doka312/SmartDesktopLamp/docs/img/build/IMG_5998-sm.jpg

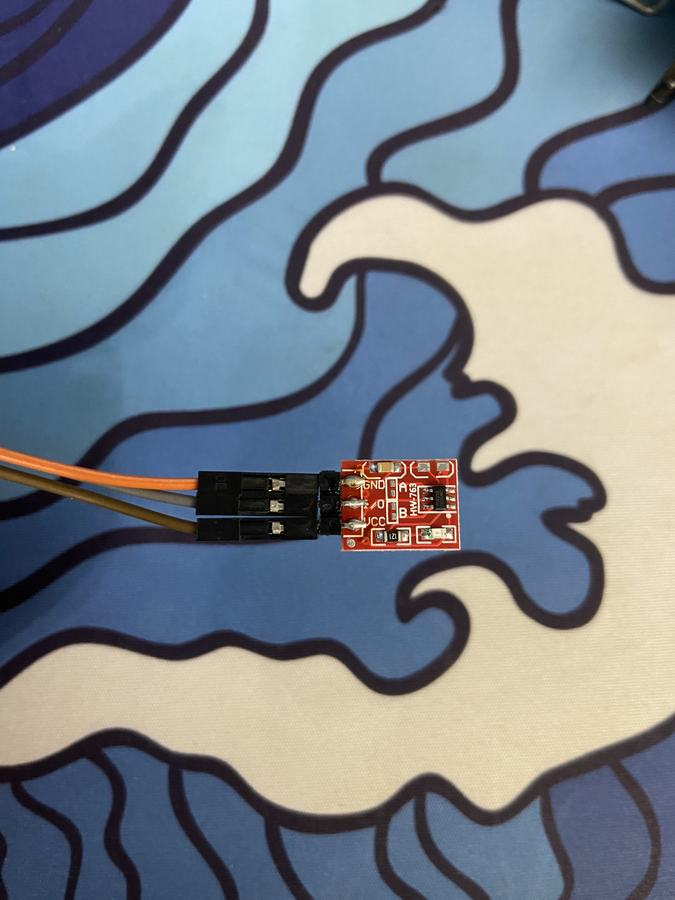
docs/img/build/IMG_5998-sm.jpg
