doka312/SmartDesktopLamp/docs/img/build/IMG_6002.jpg

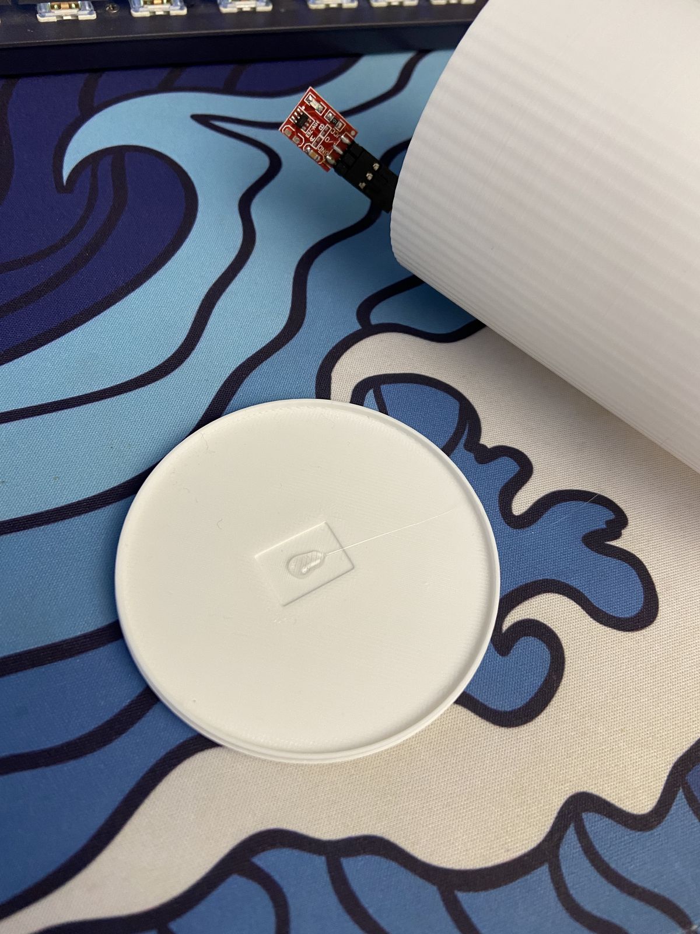
docs/img/build/IMG_6002.jpg
