doka312/SmartDesktopLamp/docs/img/chrome-port.png

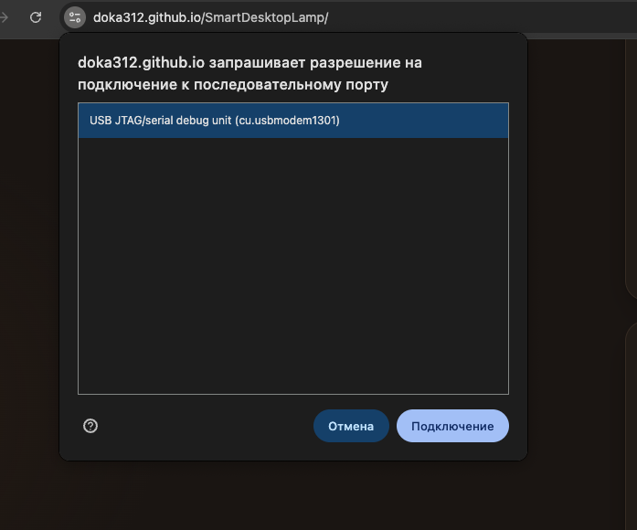
docs/img/chrome-port.png
