doka312/SmartDesktopLamp/docs/img/hero.jpg

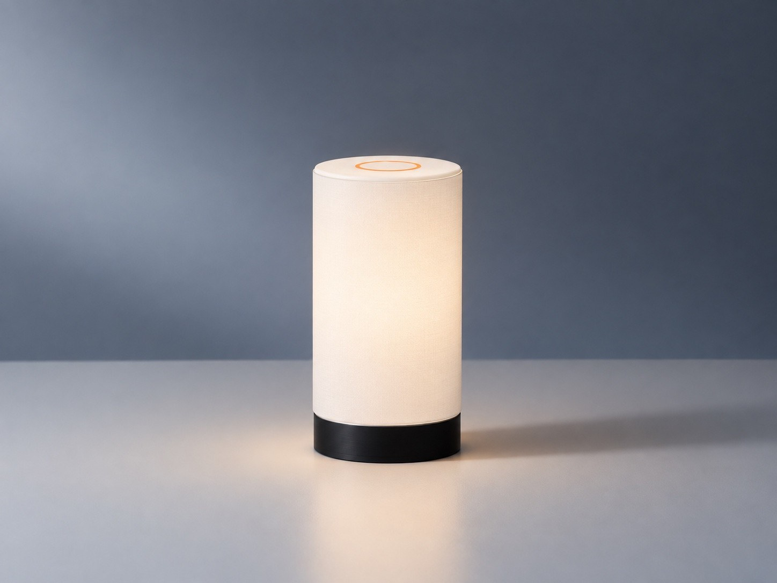
docs/img/hero.jpg
