doka312/SmartDesktopLamp/docs/img/palette.png

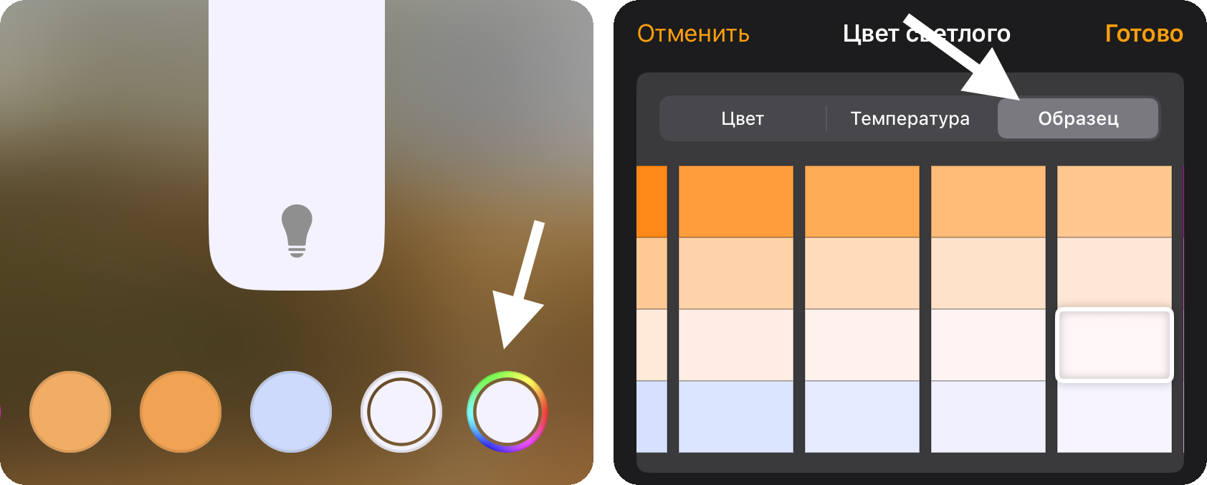
docs/img/palette.png
