doka312/SmartDesktopLamp/docs/img/tile-1.png

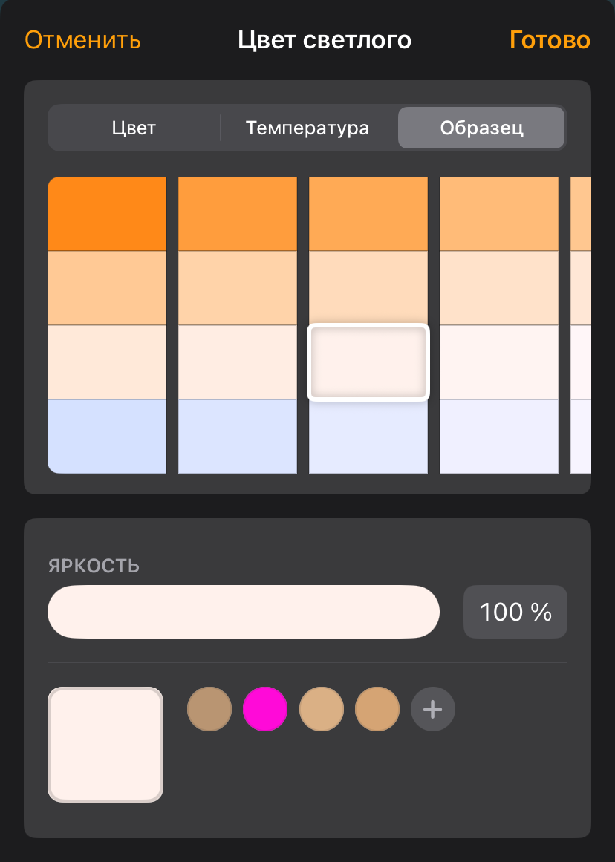
docs/img/tile-1.png
