doka312/SmartDesktopLamp/img/IMG_5999.JPG

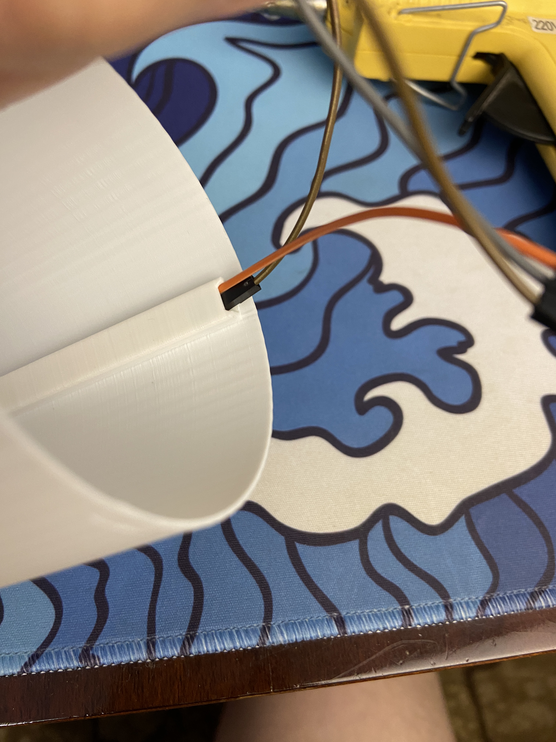
img/IMG_5999.JPG
