doka312/SmartDesktopLamp/img/IMG_6001.JPG

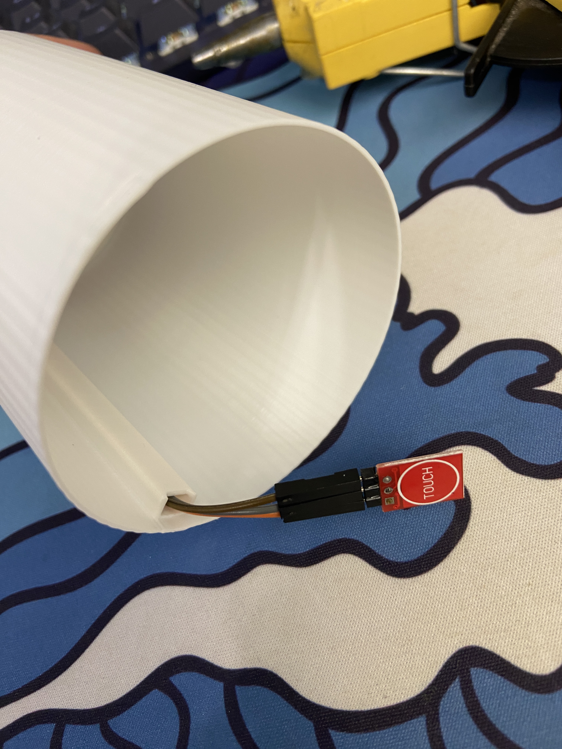
img/IMG_6001.JPG
