doka312/SmartDesktopLamp/img/IMG_6003.JPG

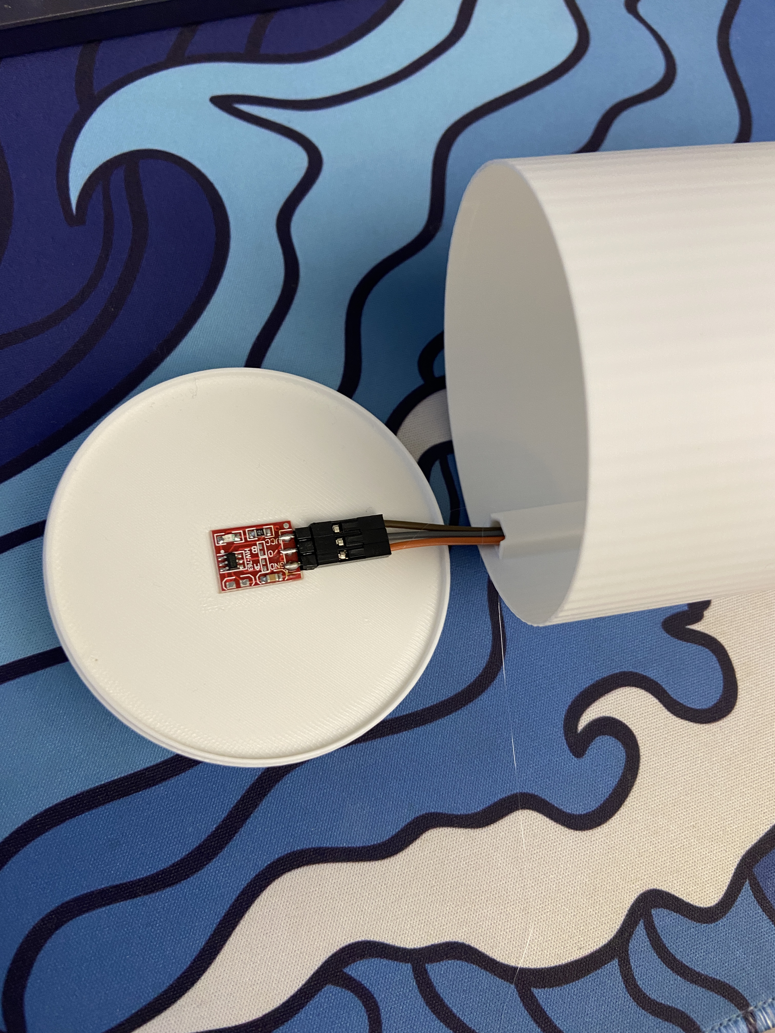
img/IMG_6003.JPG
