doka312/SmartDesktopLamp/img/IMG_6005.JPG

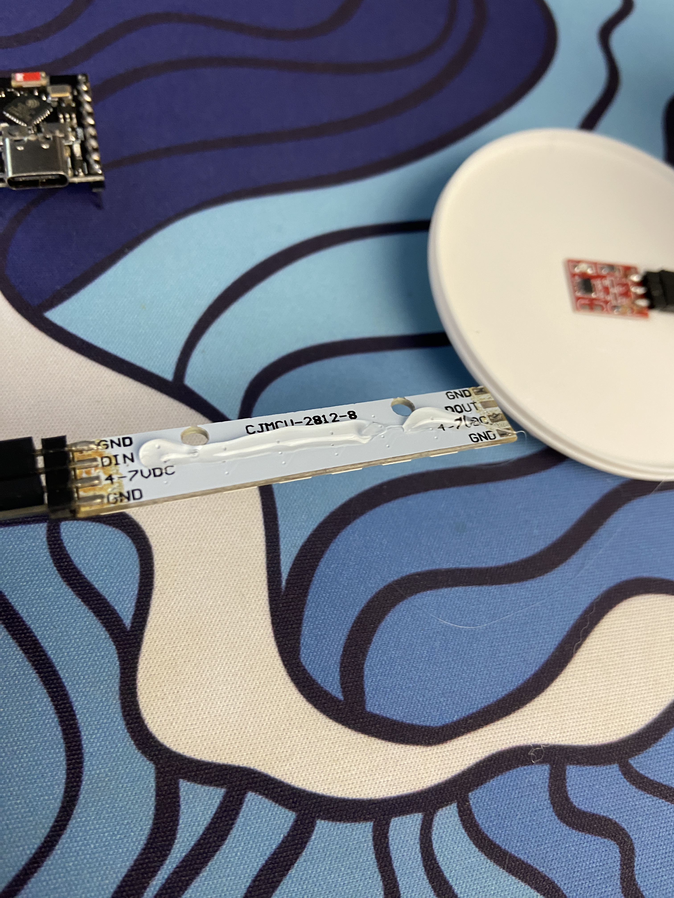
img/IMG_6005.JPG
