doka312/SmartDesktopLamp/img/IMG_6006.JPG

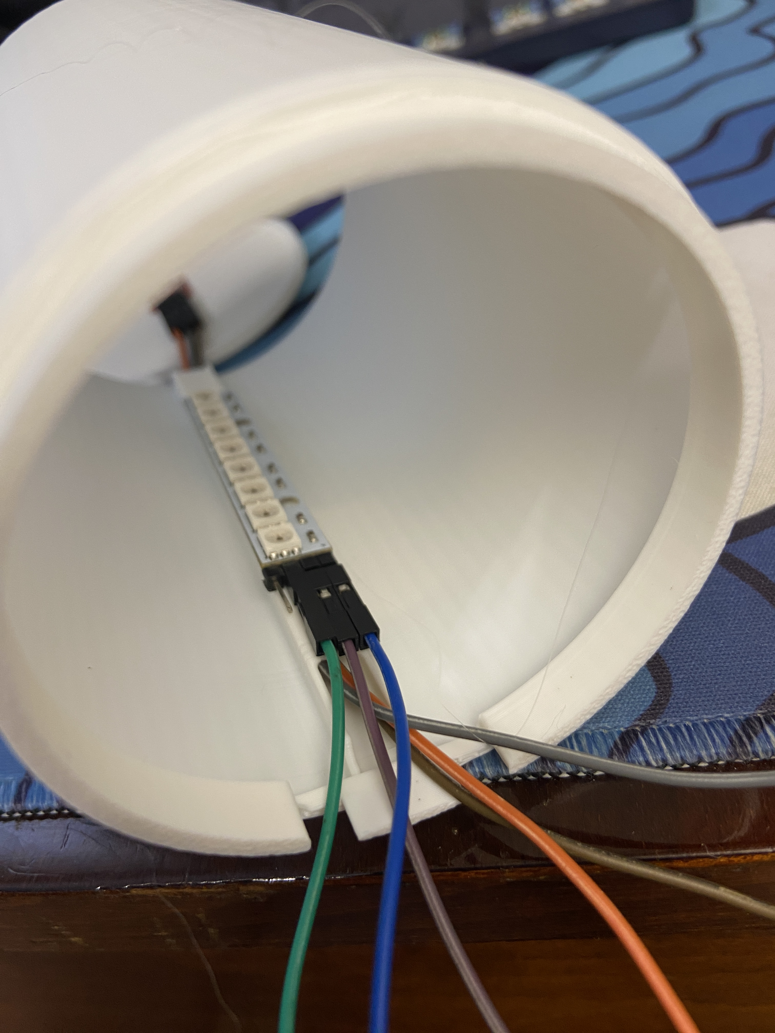
img/IMG_6006.JPG
