doka312/SmartDesktopLamp/img/IMG_6007.JPG

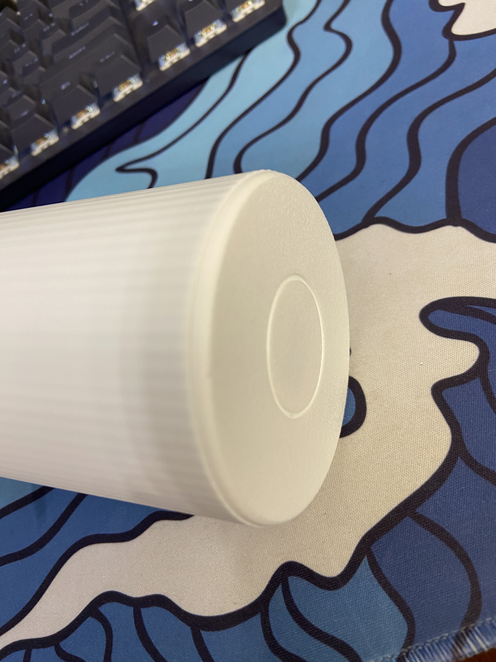
img/IMG_6007.JPG
