doka312/SmartDesktopLamp/img/IMG_6008.JPG

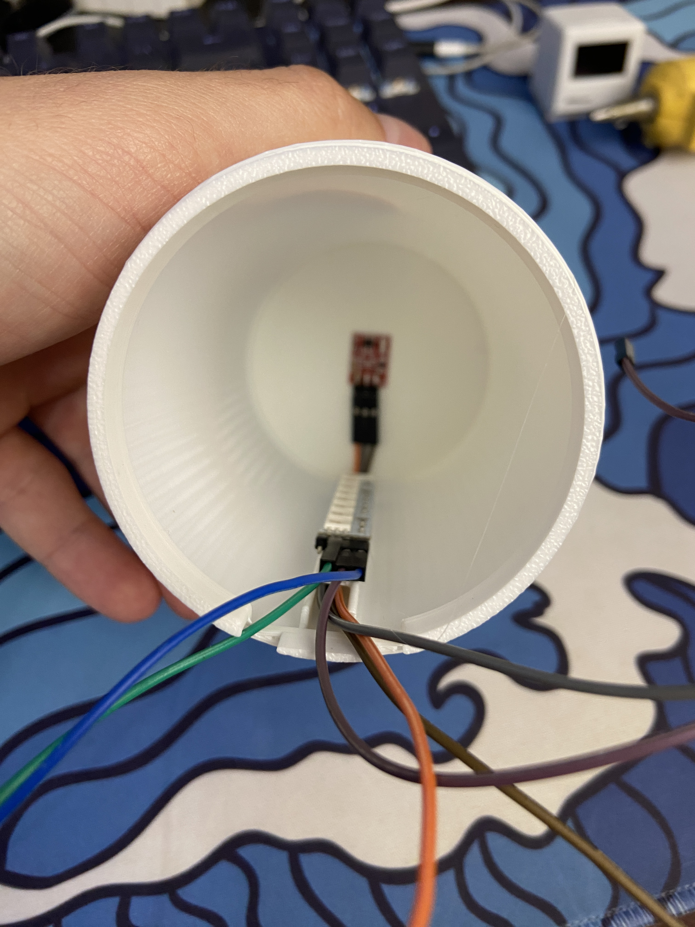
img/IMG_6008.JPG
