doka312/SmartDesktopLamp/img/IMG_6009.JPG

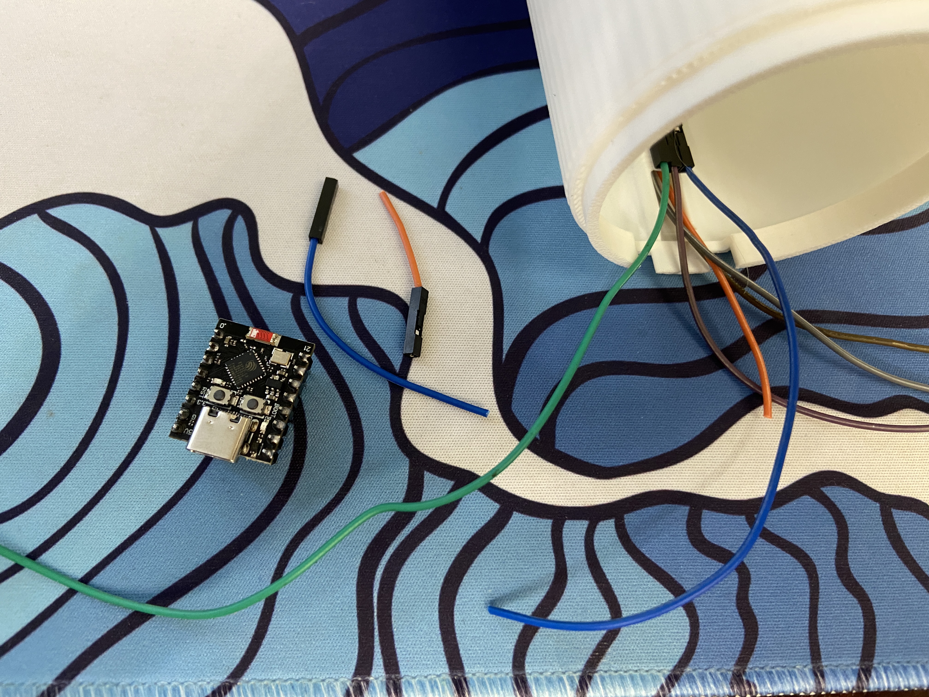
img/IMG_6009.JPG
