doka312/SmartDesktopLamp/img/IMG_6012.JPG

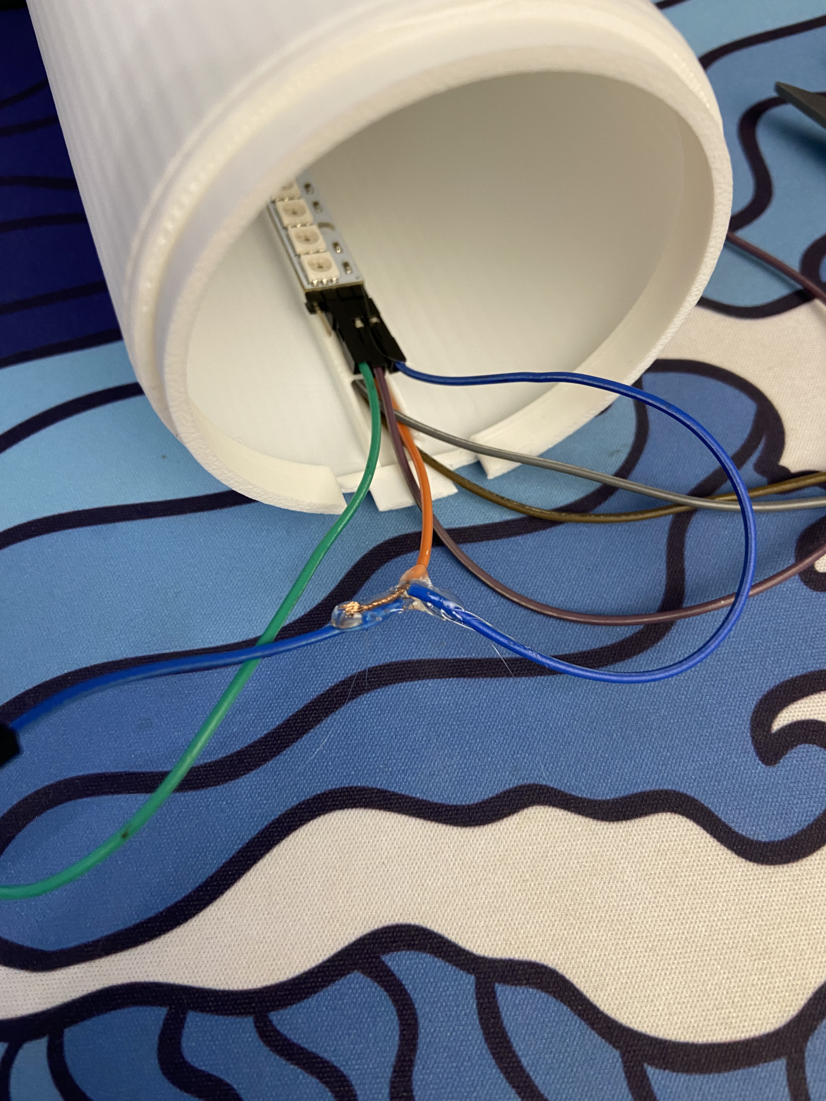
img/IMG_6012.JPG
