doka312/SmartDesktopLamp/img/IMG_6013.JPG

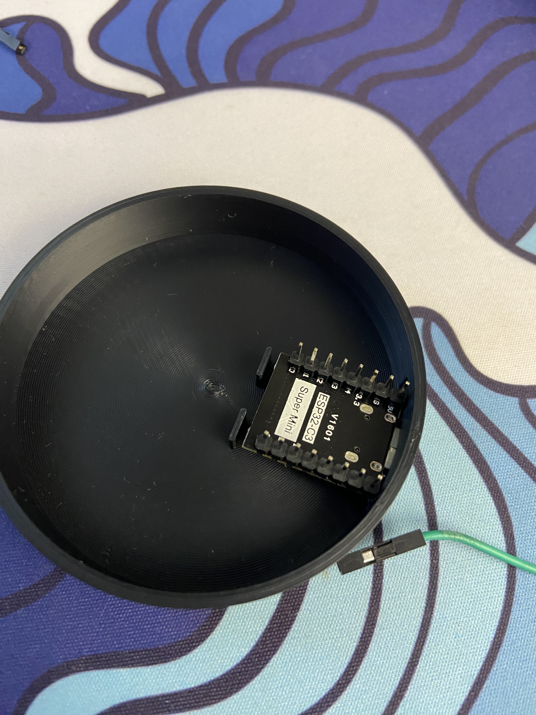
img/IMG_6013.JPG
