doka312/SmartDesktopLamp/img/IMG_6014.JPG

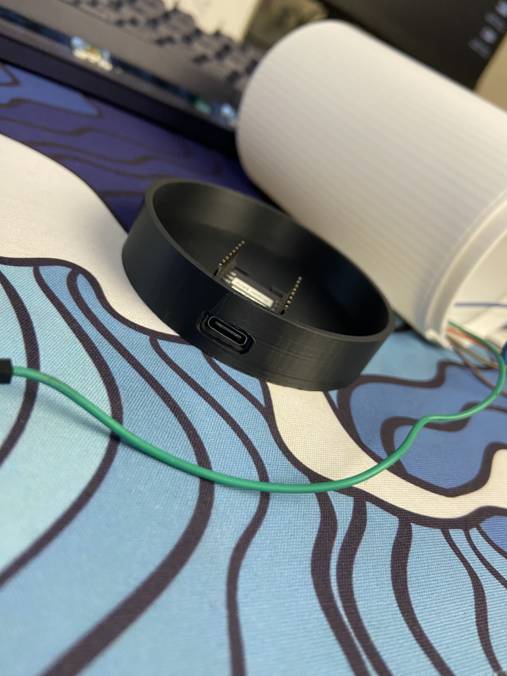
img/IMG_6014.JPG
