doka312/SmartDesktopLamp/img/IMG_6015.JPG

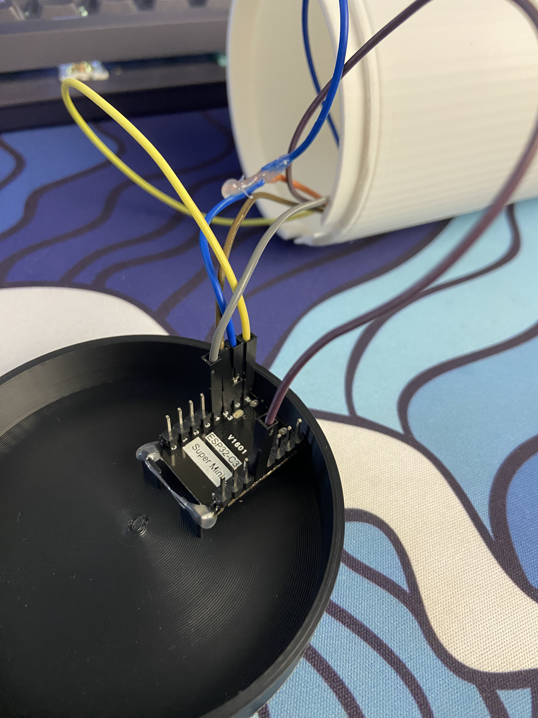
img/IMG_6015.JPG
