doka312/SmartDesktopLamp/img/IMG_6016.JPG

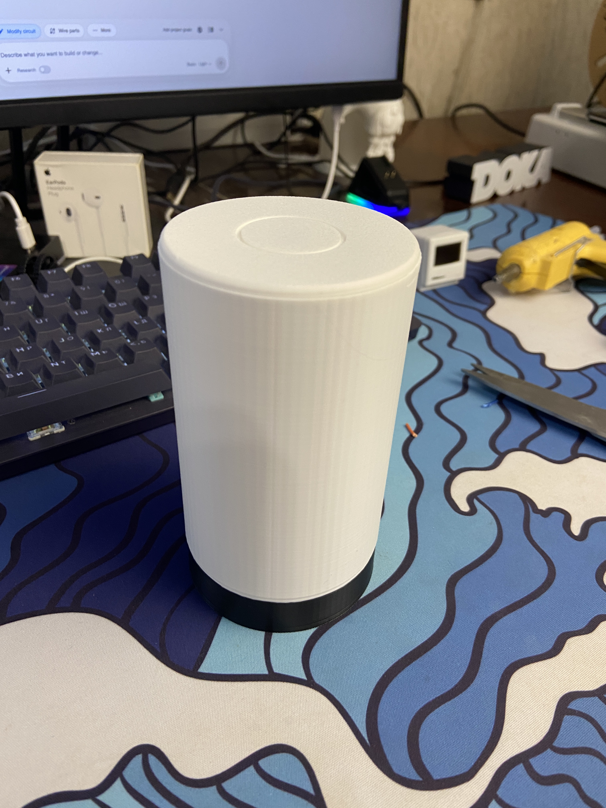
img/IMG_6016.JPG
