doka312/SmartDesktopLamp/img/IMG_6017.PNG

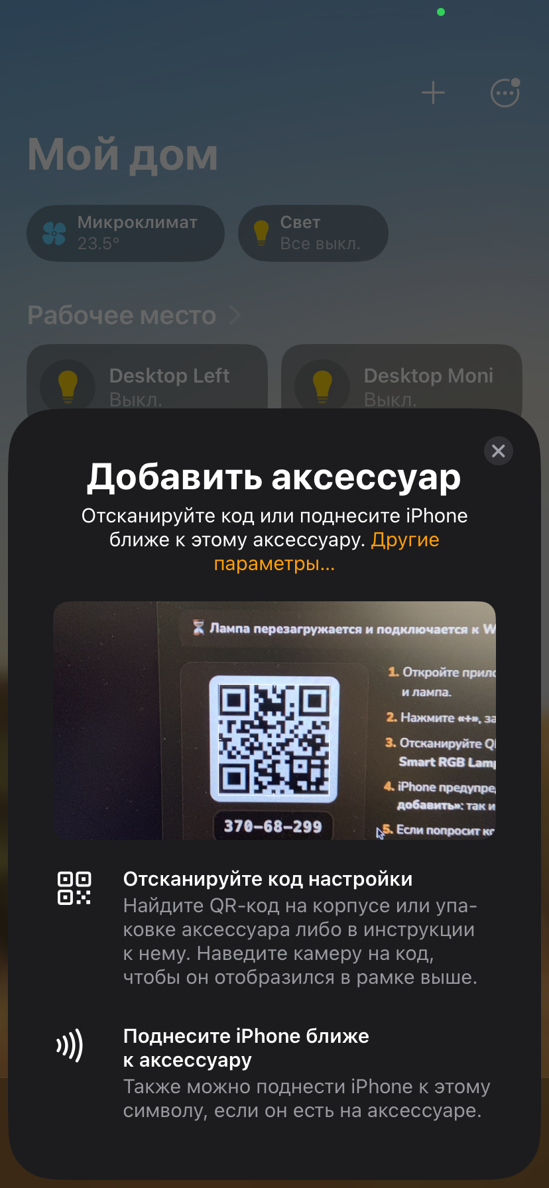
img/IMG_6017.PNG
