doka312/SmartDesktopLamp/img/IMG_6018.PNG

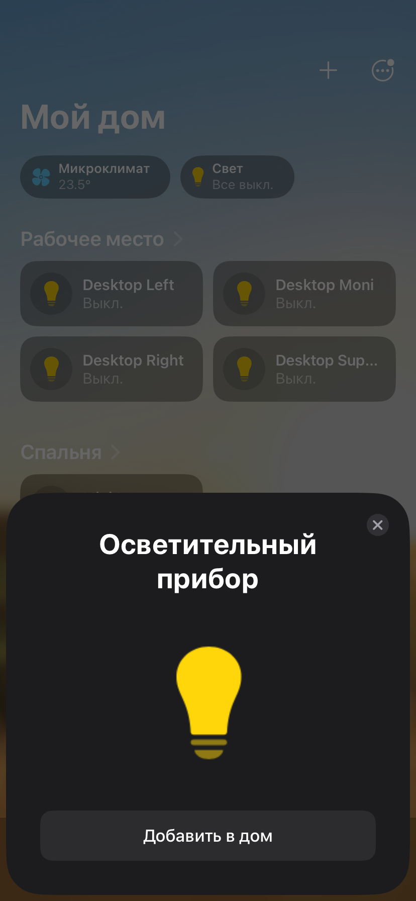
img/IMG_6018.PNG
