doka312/SmartDesktopLamp/img/IMG_6019.JPG

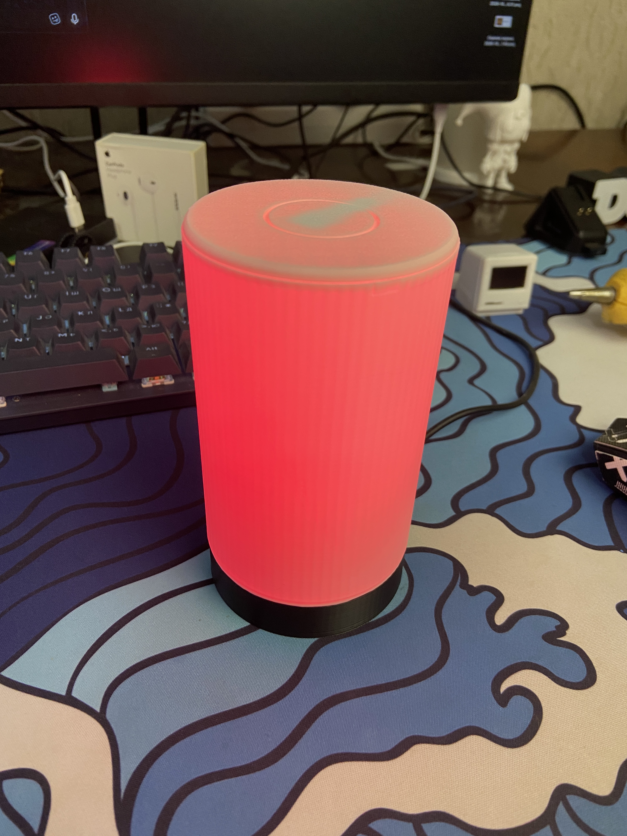
img/IMG_6019.JPG
