doka312/SmartDesktopLamp/img/IMG_6020.JPG

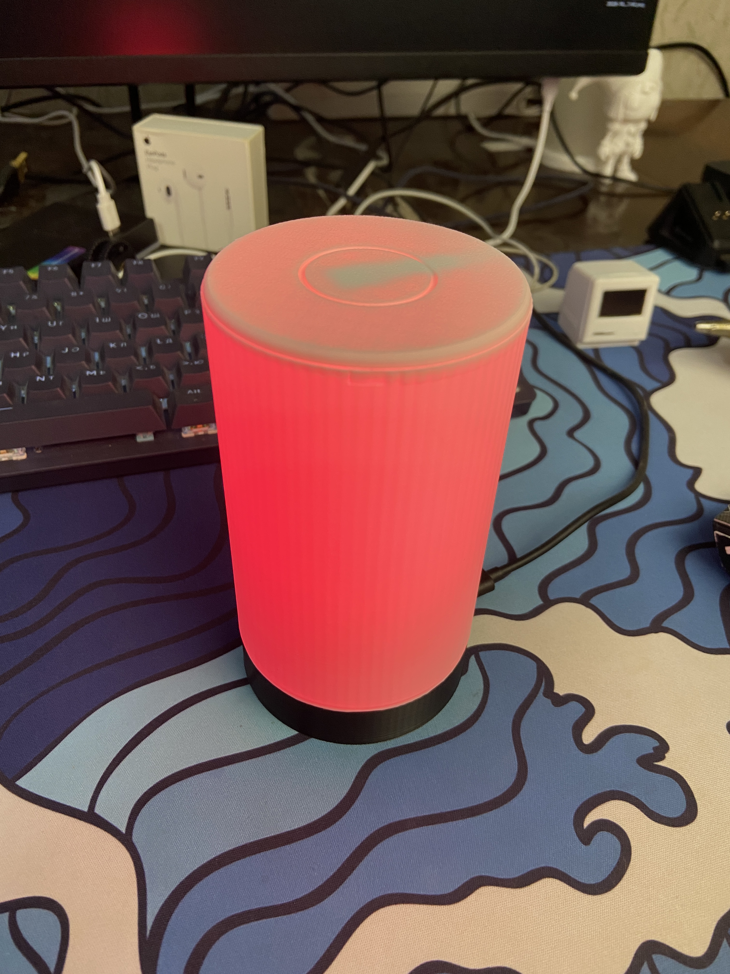
img/IMG_6020.JPG
