doka312/SmartDesktopLamp/img/IMG_6026.PNG

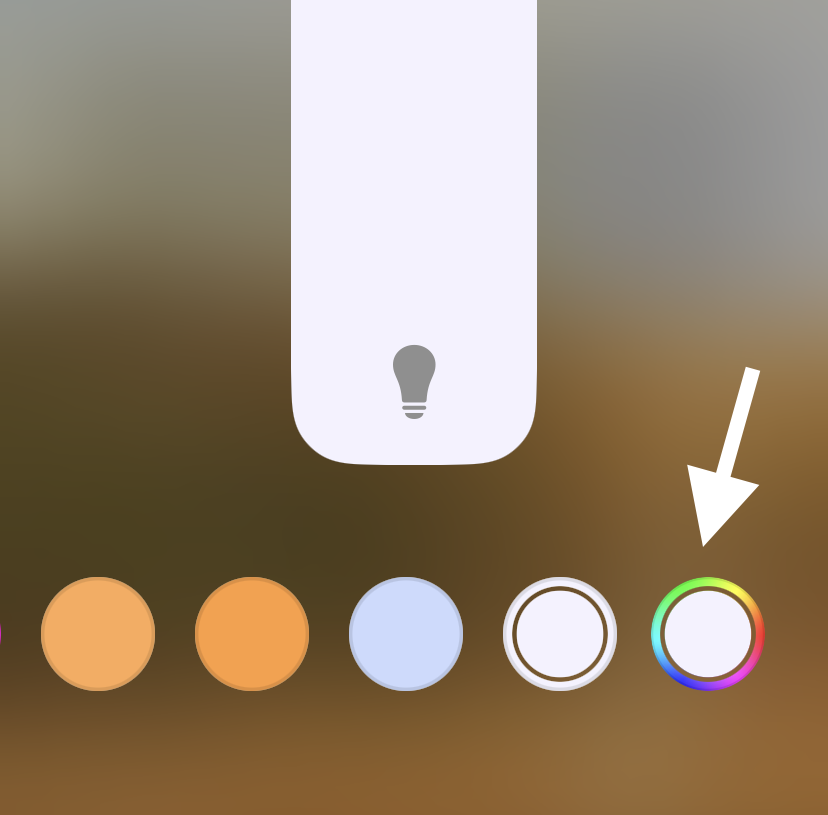
img/IMG_6026.PNG
