doka312/SmartDesktopLamp/img/IMG_6030.PNG

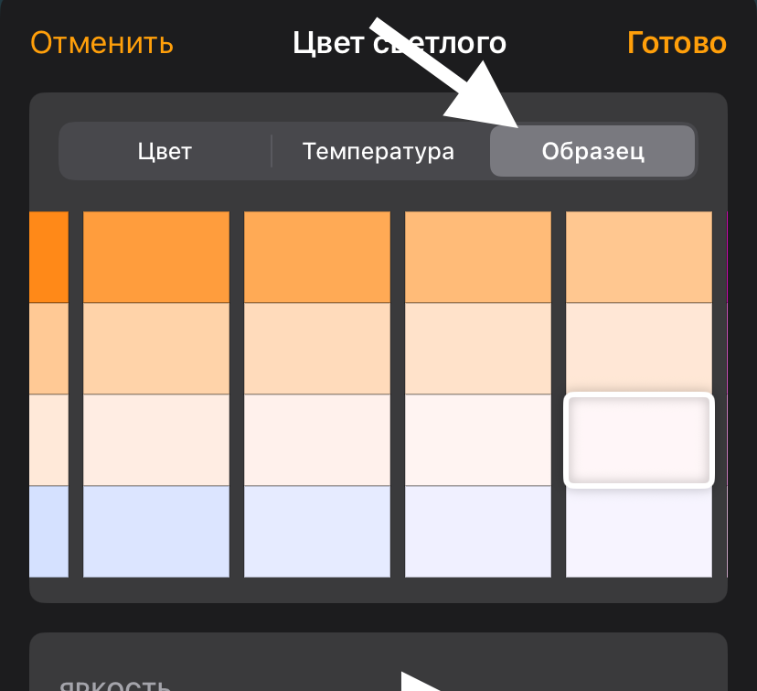
img/IMG_6030.PNG
