doka312/SmartDesktopLamp/img/Scheme.png

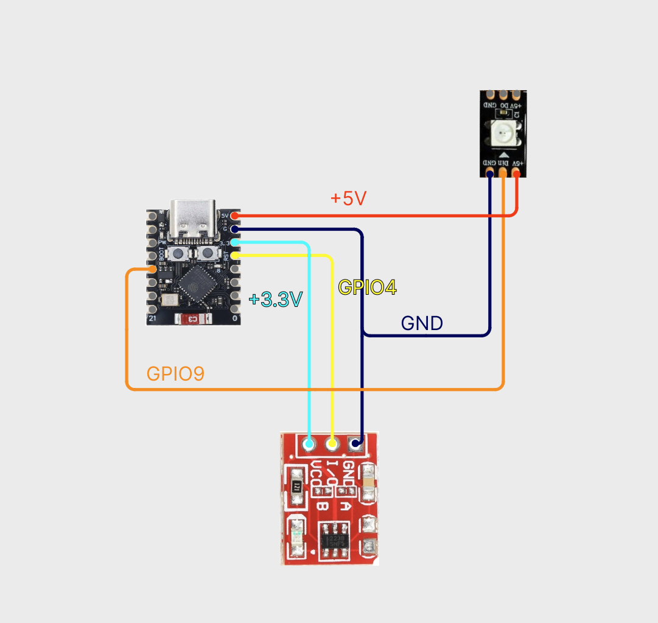
img/Scheme.png
