doka312/SmartDesktopLamp/docs/img/components/button-sm.jpg

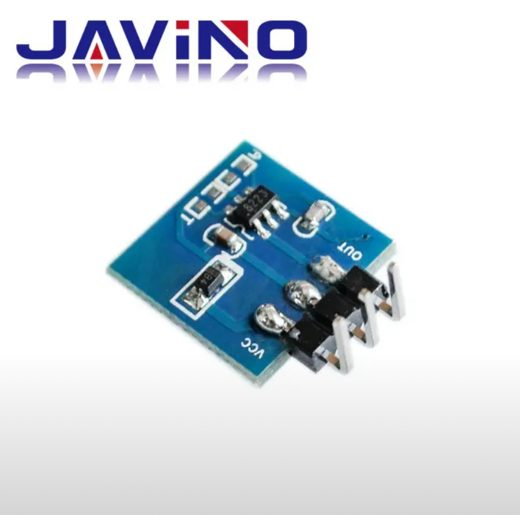
docs/img/components/button-sm.jpg
