doka312/SmartDesktopLamp/docs/img/components/esp32c3-sm.jpg

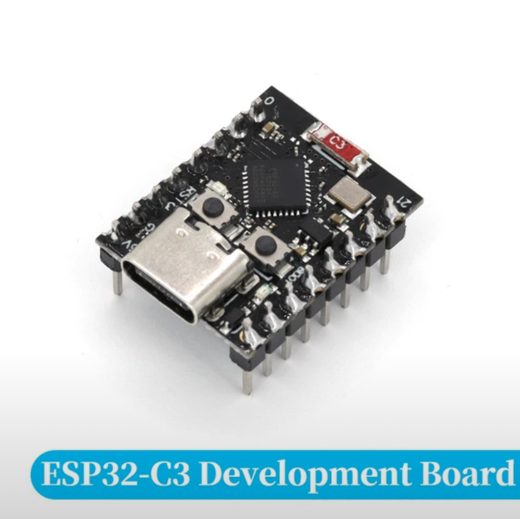
docs/img/components/esp32c3-sm.jpg
