doka312/SmartDesktopLamp/docs/img/components/led-sm.jpg

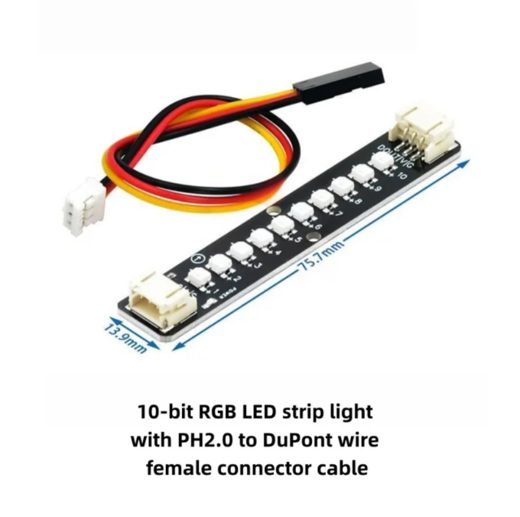
docs/img/components/led-sm.jpg
