doka312/SmartDesktopLamp/docs/img/components/wires-sm.jpg

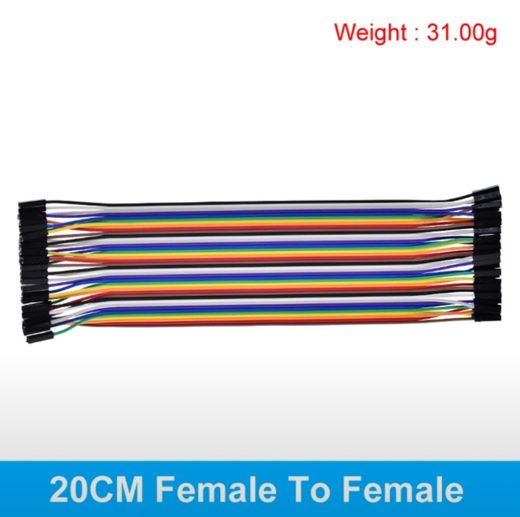
docs/img/components/wires-sm.jpg
