doka312/SmartDesktopLamp/docs/models/base.stl

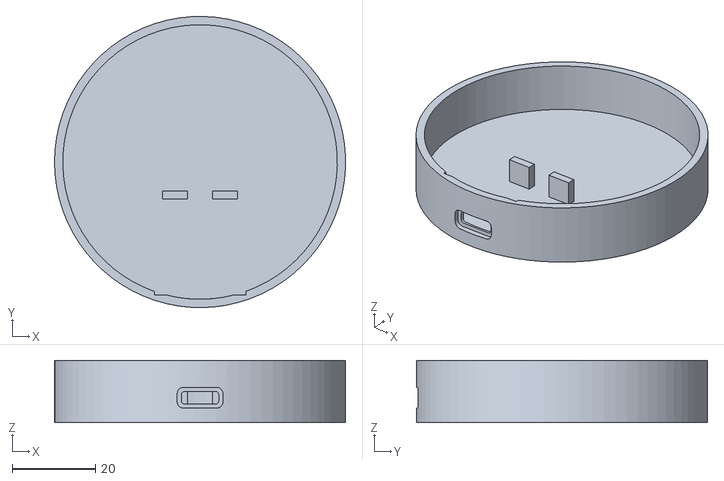
[picture p34: CAD file, 2026-10-09]
docs/models/base.stl
70.0 x 70.0 x 15.0
