doka312/SmartDesktopLamp/mini v2/deco.stl

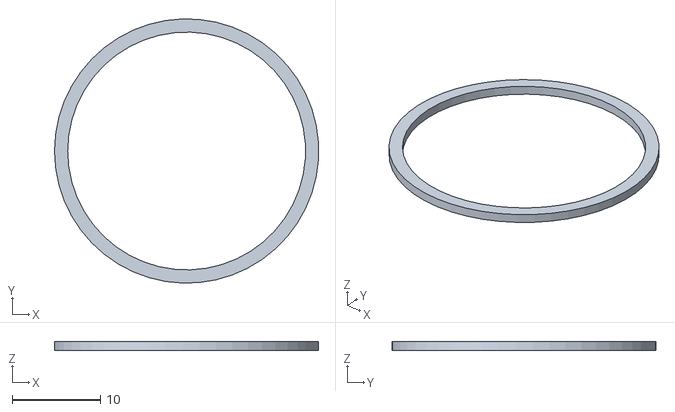
[picture p35: CAD file, 2026-10-09]
mini v2/deco.stl
30.0 x 30.0 x 1.00
