doka312/SmartDesktopLamp/docs/models/cup.stl

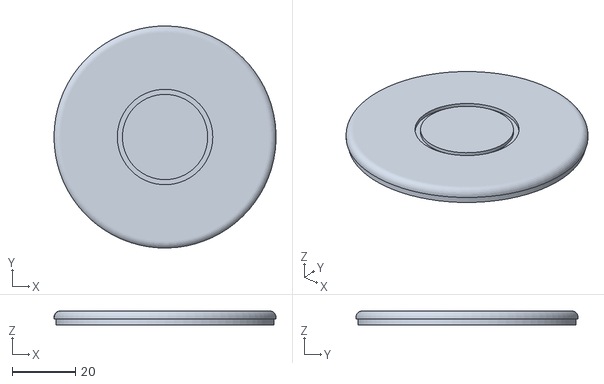
[picture p36: CAD file, 2026-10-09]
docs/models/cup.stl
70.0 x 70.0 x 4.50
