doka312/SmartDesktopLamp/mini v2/lamp mini v2.3mf

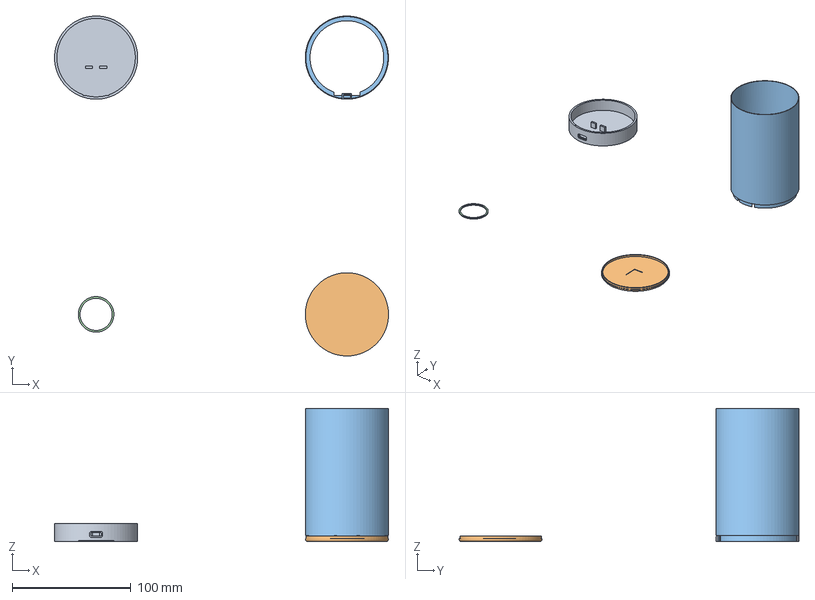
[picture p37: CAD file, 2026-10-09]
mini v2/lamp mini v2.3mf
281.0 x 286.0 x 112.0 mm
base.stl
cup.stl
MyLamp.stl
deco.stl
