doka312/SmartDesktopLamp/docs/models/diffuser.stl

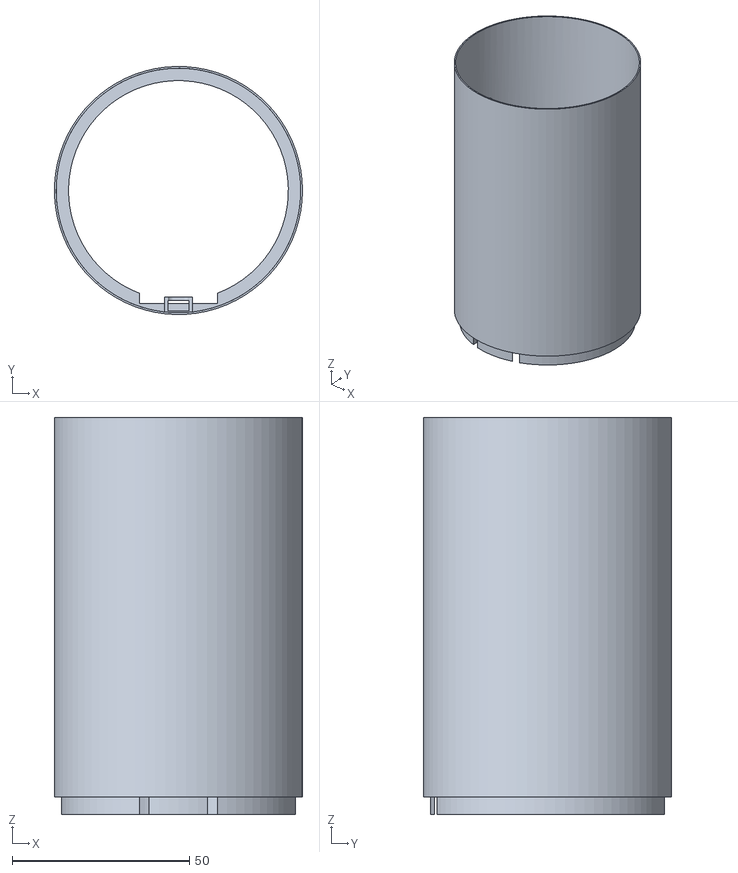
[picture p38: CAD file, 2026-10-09]
docs/models/diffuser.stl
70.0 x 70.0 x 112.0
