doka312/SmartDesktopLamp/(notices)

Notices in the files:
README.md:
License: MIT
