doka312/SmartDesktopLamp/img/IMG_5996.JPG

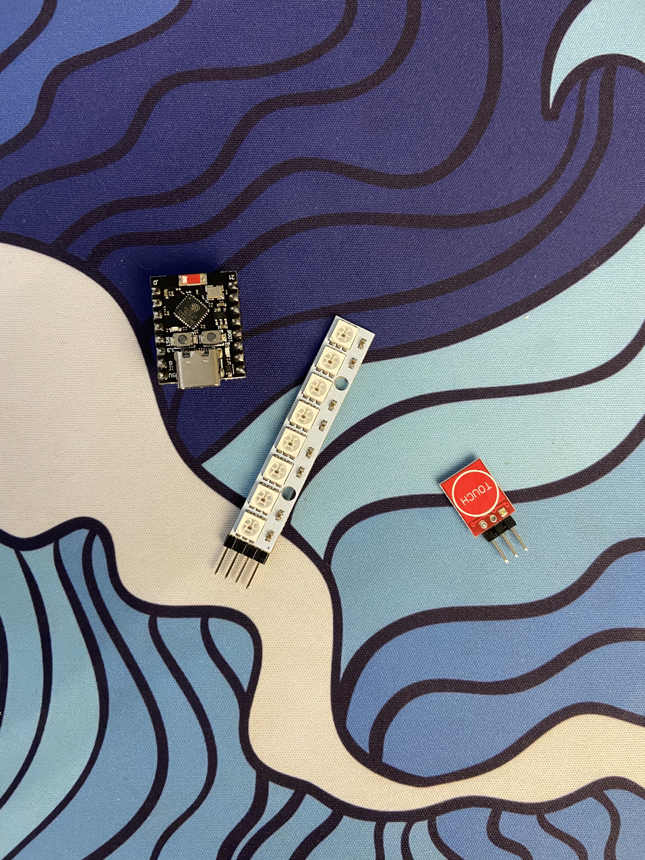
img/IMG_5996.JPG
