doka312/SmartDesktopLamp/img/IMG_6010.JPG

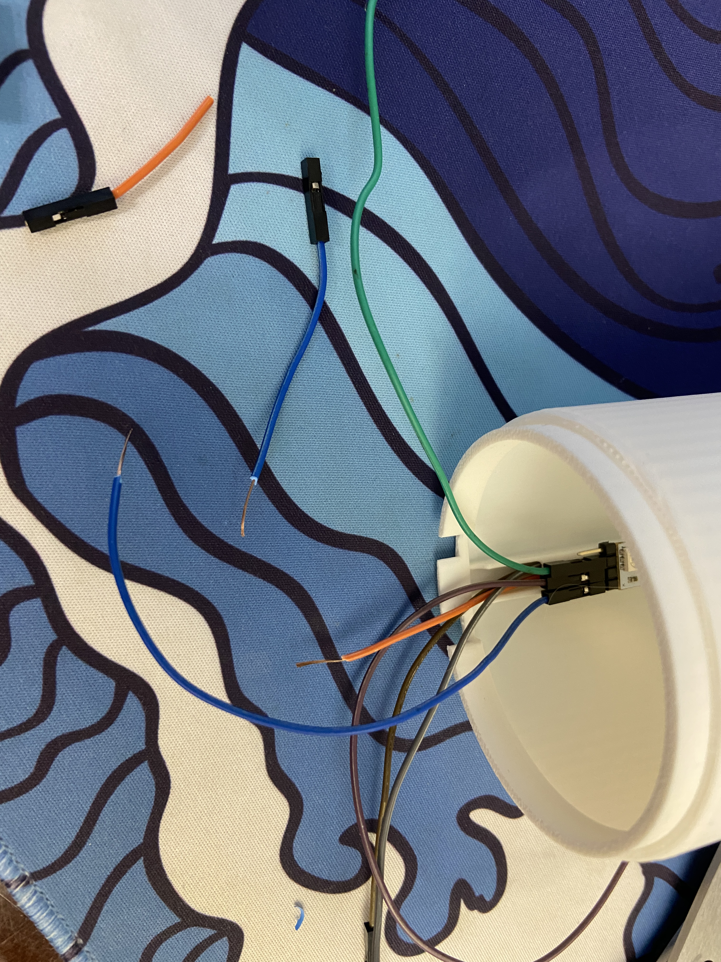
img/IMG_6010.JPG
