doka312/SmartDesktopLamp/img/IMG_6011.JPG

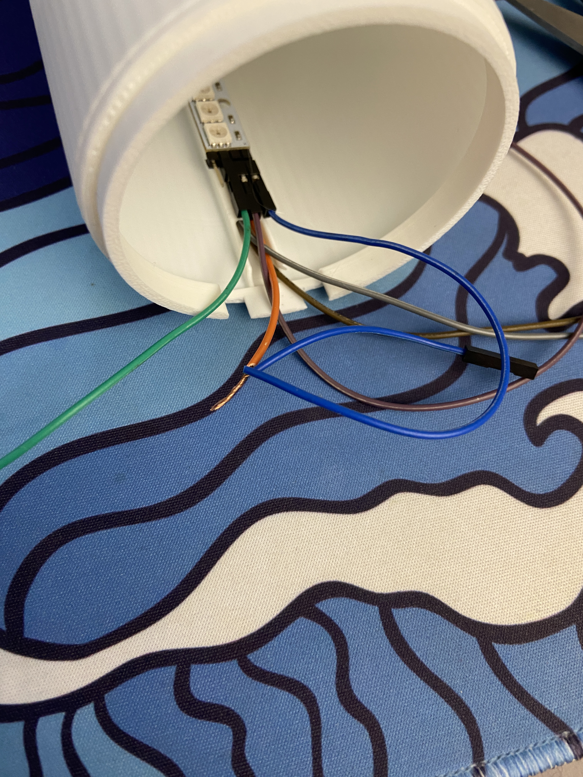
img/IMG_6011.JPG
